mslaby96/spindle/hardware/stand/cover.stl

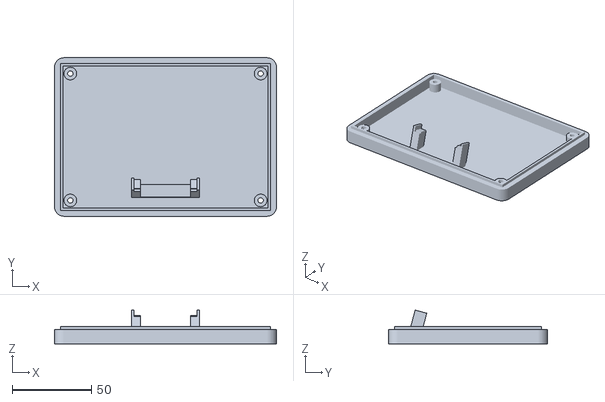
[picture p1: CAD file, 2026-11-01]
hardware/stand/cover.stl
140.0 x 100.0 x 21.3
