mslaby96/spindle/hardware/stand/clip.stl

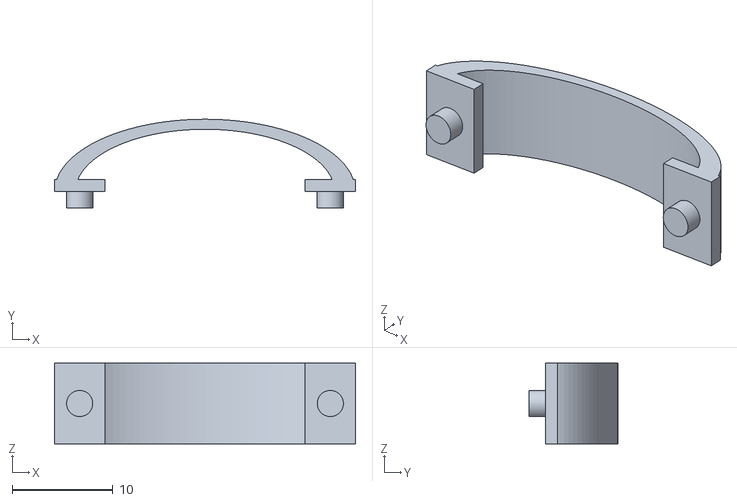
[picture p2: CAD file, 2026-10-30]
hardware/stand/clip.stl
29.9 x 8.80 x 8.00
