mslaby96/spindle/hardware/stand/foot.stl

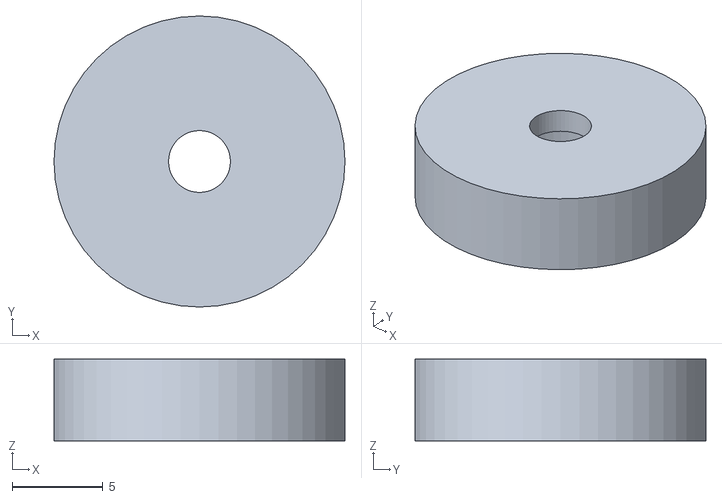
[picture p3: CAD file, 2026-10-30]
hardware/stand/foot.stl
16.0 x 16.0 x 4.50
