mslaby96/spindle/hardware/stand/body.stl

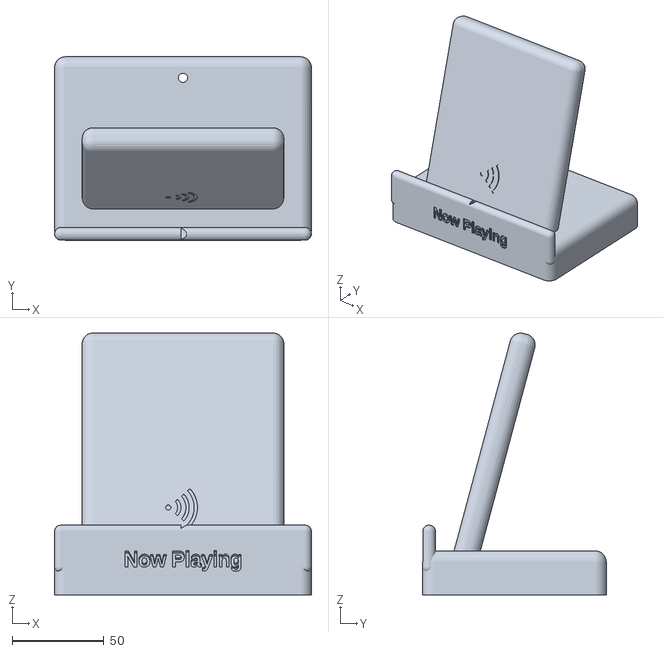
[picture p4: CAD file, 2026-10-29]
hardware/stand/body.stl
140.0 x 100.0 x 142.6
