mslaby96/spindle/(commit log)

2026-10-27 Add account setup, login sessions and device tokens
2026-10-27 Add device report endpoint and live event stream
2026-10-27 Add Pico W firmware for the now playing stand
2026-10-27 Track listening sessions from the stand with confirmation for long ones
2026-10-28 Fix edge cases in sessions, inbox and login limits; tidy up
    [runner.py]
2026-10-28 Keep the driver licence out of the files copied to the Pico
2026-10-28 Fix MFRC522 SPI writes on MicroPython 1.2x and add a reader probe
2026-10-28 Halt the tag after each read instead of cycling the antenna
2026-10-28 Add a printable now playing stand
    [body.stl, cover.stl, stand.scad]
2026-10-28 Give the stand cover feet with recessed screw heads
    [cover.stl, stand.scad]
2026-10-28 Mark the reader on the backrest and smooth the front face
    [body.stl, stand.scad]
2026-10-28 Load the reader from below and close the back of the stand
    [body.stl, spacer.stl, stand.scad]
2026-10-28 Keep the reader's pin header inside the base
    [body.stl, spacer.stl, stand.scad]
2026-10-28 Let the reader board locate its spacer
    [spacer.stl, stand.scad]
2026-10-28 Keep the web app in step with the server after drops and expiry
    - any 401 re-checks the session, so an expired login lands on sign in
    instead of a page full of errors, and the event stream stops retrying
    - after the stream reconnects, now playing, inbox and catalogue state
    are fetched again since missed events are not replayed
    - assigning a sleeve updates now playing straight from the response
    - cataloguing is re-checked when it is due to lapse
    - the startup gate shows an error with a retry instead of loading forever
    - test fetch mock rejects writes without the X-Spindle header
2026-10-28 Make the stand fail visibly and back off when the server is down
    A bad pin or LED setting crashed before the error pattern was shown and
    the watchdog rebooted the board in a loop; config is now checked up front
    and hardware is set up before the watchdog starts. A reader exception no
    longer ends the loop, failed reports back off up to 30 s, the HTTP
    timeout leaves room inside the watchdog window, and a Wi-Fi attempt stuck
    in connecting is retried.
    [net.py, report.py, runner.py]
2026-10-28 Share the devices query, pressing format and debounce hook
    Each was written out in two places.
2026-10-29 Pin what listen events and classification report
    Mutation testing showed the tests never checked that a new listen is
    announced as active, when it started, the exact long-listen boundary,
    that a discarded listen credits no time, or that ClassifyAlbum handles
    every waiting listen.
2026-10-29 Split the most complex server functions
    Every function now scores under 10 on crap4go. HTTP handlers share one
    table that maps domain errors to statuses instead of each repeating
    its own switch; the dominant colour picks a fixed bucket on ties instead
    of depending on map order. Behaviour is otherwise unchanged and covered
    by the existing tests.
2026-10-29 Tell Home Assistant when Spindle shuts down
    The MQTT connection shared the server's context, so it was already
    closing when the offline message went out and the broker kept the
    retained "online". The connection now lives until the offline message
    is sent and the client has disconnected.
2026-10-29 Drop an unreachable empty-colour branch
    Every mean is built from at least one sample.
2026-10-29 Cover what mutation testing showed the tests missed
    Boundaries (session idle deadlines, login backoff, catalogue expiry,
    ratings, limits, track counts), sources tried in order, error paths
    that reach the user, and constants the tests used to compare against
    themselves.
2026-10-29 Test the MQTT last will, status filter and cover scaling
    A third mutation pass on single workers showed the earlier config and
    publisher results were noisy. The broker now drops the publisher's
    socket to check the offline will, only an "online" on Home
    Assistant's status topic triggers a resync, and covers wider or taller
    than 600 px are scaled on that side. Config defaults, the summary and
    the secret and factor boundaries are pinned too.
2026-10-29 Make the reader spacer part of the cover and print the feet separately
    A loose spacer could tip over or fall out while the cover was off. It
    now stands on the cover, which prints flat side down; the feet are
    separate pieces held by the cover screws, centred by a small ring.
    The spacer's lips get 0.3 mm more room since the screws now decide
    where it sits. Checked in OpenSCAD that the cover clears the body, the
    reader board and the Pico.
    [cover.stl, foot.stl, spacer.stl, stand.scad]
2026-10-29 Say that the base ceiling needs support
    The underside of the base spans about 13 x 9 cm, too far to bridge.
2026-10-29 Print the base without overhangs at the bed edge
    The base's bottom edges were rounded like the top, which made a lip
    right above the bed that the slicer supported all round, and the USB
    opening had a flat roof. The bottom edges are now straight and the
    opening has a 45 degree roof. The README lists support settings that
    keep the slot clear and the support easy to remove.
    [body.stl, stand.scad]
2026-10-29 Size the screw holes for M3 x 20 machine screws
    Wider bosses with a 2.5 mm pilot hole, 3.4 mm clearance in the cover
    and feet, and taller feet whose recess takes pan, socket or countersunk
    M3 heads.
    [body.stl, cover.stl, foot.stl, stand.scad]
2026-10-29 Leave nothing but the base ceiling for the slicer to support
    The screw holes in the bosses ended flat, so supports grew up inside
    them, and the tops of the engraved letters on the front were flat
    overhangs that got a support wall up the face. The holes now end in a
    point and the letters run into the face at 45 degrees.
    [body.stl, stand.scad]
2026-10-29 Let a stand pair itself with a short code from the app
    The app asks for a six-character code that lasts ten minutes; a stand
    being set up sends it to /api/device/v1/pair and gets its token back.
    Codes skip look-alike characters, work once, and wrong guesses are
    rate limited per address. The app hears about the new stand over the
    event stream.
2026-10-29 Set a stand up from a phone instead of a config file
    A stand without Wi-Fi settings opens an open network named Spindle-XXXX
    with a captive setup page: pick a network, type its password, the
    server address and the pairing code from the app. The stand joins the
    network, trades the code for its token, saves its settings and
    restarts. Holding BOOTSEL for five seconds forgets the Wi-Fi, and five
    minutes without the usual network opens the setup page while the old
    network keeps being retried. Open networks with an empty password now
    pass the config check.
2026-10-29 Walk through setting a stand up from a phone in the app
    The stands page says up front how adding a stand works, then lists the
    steps: plug it in, join its Spindle network, pick the home Wi-Fi, type
    the server address shown right there and the code. Opened as localhost,
    the page warns that the stand needs the computer's home network address
    instead. A "Something not working?" section covers a missing setup
    network, a dropped phone connection and an unreachable server.
2026-10-29 Remove the duplication dry4go found in the server
    Token hashing lived in both auth and devices and now sits in one
    secrets package. Handlers share reply, act and fetch instead of each
    spelling out the call, error and JSON steps, and every missing album is
    the same known error. The Discogs master and release fetches share one
    generic lookup.
2026-10-29 Turn copy-pasted tests into tables
    The dominant colour, Last.fm tracklist and repeated-play tests repeated
    the same body per case, and the fake Discogs did the same lookup twice.
    Cover removal gets its own test now that it is a store method.
2026-10-30 Pin what mutation testing found unchecked in album removal
    A single listen is enough to ask before moving it, the removal time is
    stored to the second, a cover that can't be deleted is reported, the
    app is told only about album changes that happened, and album lengths
    are checked at both ends.
2026-10-30 Fit the cover flush and hold the reader still, without reprinting the body
    The cover now sits inside the base, flush with its bottom, with the
    bosses through it, and wider feet hold it up. The spacer is sized to
    the measured 39.4 x 59.8 mm board and pushes it against the top of its
    pocket, with a 1 mm lip behind its edge that clears the crystal. A
    printed clip on the antenna-end mounting holes presses the antenna
    against the front of the pocket. The body renders to the same geometry
    as before, and OpenSCAD shows no part running into another.
    [clip.stl, cover.stl, foot.stl, stand.scad]
2026-10-30 Drop a check filingKey can never fail
    The key is trimmed before "the " is cut, so something always follows.
2026-10-30 Take a cover's colour from its most colourful area
    The largest colour area often isn't what a cover looks like: on Damn it
    was the shirt, a pale lavender that appears nowhere else. A colourful
    area covering at least 5% of the cover now wins over a larger pale one;
    covers without one keep the old rule. Tests pin both thresholds on each
    side. Store.Color reads a stored cover back for recolouring.
2026-10-30 Add a command to pick cover colours again
    Albums catalogued before the new colour rule keep their old colour.
    spindle recolor-covers recomputes it from every stored cover, reports
    covers it can't read and carries on with the rest. Home Assistant gets
    the new colour with the next now playing update.
2026-10-30 Give the sort dropdown its own arrow
    The browser's arrow sat squeezed against the right edge and looked out
    of place next to the filter field. The select now draws its own arrow
    in the secondary text colour with room on the right, matches the field
    beside it and highlights its border on hover.
2026-11-01 Put the cover back under the base as a tray with more room
    The flush cover could slide up the bosses with nothing to hold it while
    assembling, and wires on a breadboard didn't fit above it. The cover is
    now a tray with the base's outline that adds 6 mm inside; its rim drops
    into the base to line it up, posts under the bosses take the screws,
    and the reader spacer stands on its floor. The body renders unchanged
    and nothing collides.
    [cover.stl, stand.scad]
2026-11-01 Open stand setup in the browser instead of a captive portal sheet
    On an iPhone the captive portal sheet closes, and leaves the network,
    as soon as you switch to another app, say to copy a Wi-Fi password.
    The stand now answers the phones' connectivity checks as online, so no
    sheet appears, and the setup page is opened at http://spindle.setup in
    the browser, which survives switching apps. Any other name still leads
    to the page.
2026-11-01 Mark a sleeve taken off the stand with a sticker
    While the listen winds down, a "Sleeve off" sticker states what
    happened, the countdown is set in the clock's condensed numerals and
    the "End listen now" button sits below it, all under a rule that
    separates it from the progress bar.
2026-11-01 Let an empty stand idle on less power
    With nothing on it the stand reads every 300 ms with the reader's field
    up only for the read, lets the Wi-Fi doze between beacons, and the
    server asks it to report every 30 s instead of 1.5 s; putting a sleeve
    on is still reported at once and confirmed at full speed. Checked on
    the stand: reads with the field switched per read are as reliable as
    with it on, and a test pins that going back to full speed turns the
    field on again, which the first hardware run caught.
2026-11-01 Back up the database and covers, and restore them
    The server writes a backup every SPINDLE_BACKUP_EVERY (24 h by default)
    into SPINDLE_BACKUP_DIR and keeps the newest SPINDLE_BACKUP_KEEP. It
    starts at once when the last one is already that old, so restarts don't
    push it back. Docker mounts SPINDLE_BACKUP_PATH from the host there.
    The database is copied with VACUUM INTO, so it is consistent while the
    server keeps running. spindle backup makes one by hand. spindle restore
    checks the archive, takes only the database and cover files from it,
    and moves the current data aside instead of deleting it.
2026-11-01 Split the backup archive steps
    writeArchive, extract and Restore were over a CRAP of 10; the covers,
    each archive entry, and unpacking versus moving in are now their own
    functions. The backup tests pin the behaviour.
2026-11-01 Pin what mutation testing found unchecked in backups and export
    Every cover goes into a backup, pruning leaves other archives in the
    folder alone, an oddly named file doesn't make a backup due, a database
    without covers is still moved aside on restore, the scheduler keeps
    going after the first backup, and export times are exact.
2026-11-01 Name backups in local time and say where restore put the old data
    Backup names used the container's UTC clock instead of SPINDLE_TZ.
    Restore now returns the before-restore folder, so the command only
    mentions one when something was actually moved there.
2026-11-01 Show the data downloads as buttons
    The JSON and CSV export links on the account page rendered as plain
    underlined links. Links marked as buttons now look and size like the
    buttons next to them, and a row of them sits side by side from the left.
2026-11-01 Reset the reader when it gets stuck
    Cheap RC522 boards can lose their settings after a dip in power or stop
    answering on SPI, and then read every sleeve as nothing on the stand
    until the Pico is restarted. An empty stand now checks every 30 s that
    the reader still holds what it was set up with, and if not, resets it
    through its RST pin and sets it up again. Checked on the stand: no false
    alarms on a healthy reader, and knocking its settings out gets healed
    on the next check. Firmware is now 0.3.0.
    [health.py, reader.py, runner.py]
2026-11-01 Tell when a stand goes offline and keep its diagnostics
    A stand counts as offline after 90 s without a report and comes back with
    its first one. Reports may carry Wi-Fi signal, reader resets and uptime;
    the app gets them with the stand list and a device_status event when a
    stand goes quiet or comes back.
2026-11-01 Send Wi-Fi signal, reader resets and uptime with each report
    [net.py, report.py, runner.py]
2026-11-01 Show whether each stand is online and how it is doing
    Each stand on the Stands page carries an Online or Offline sticker, says
    since when it has been offline, and lists what it last reported: Wi-Fi
    strength in words with the dBm next to it, reader resets and uptime,
    marked as last known while it is offline. The page refreshes those
    every 30 seconds. When nothing is playing and every stand is offline,
    Now playing says the stand isn't answering and what to check instead of
    asking for a sleeve. Tests pin the signal thresholds at -67 and -80 dBm,
    the uptime wording and both empty states.
2026-11-01 Let a stand's Wi-Fi be changed from the Stands page
    Change Wi-Fi first explains what will happen: the stand forgets its
    network, opens its own Spindle- network and keeps its history, and
    setup continues on the phone at http://spindle.setup. After confirming,
    the stand shows a Wi-Fi change sticker and waits for the stand to pick
    the request up, which can be cancelled until then; an offline stand
    says it will pick it up when it is back. Once it does, the page says
    what to do next on the phone.
2026-11-01 Let the stand install firmware from its server and roll back a bad one
    A new version is downloaded into next/, checked file by file and put in
    place at the next boot, with the old files kept in prev/. Until the new
    version reaches the server, main.py keeps a watchdog running; three
    resets in a row, or ten minutes without the server, bring the old
    version back.
    [main.py, net.py, ota.py, patterns.py, report.py, runner.py]
2026-11-01 Give stands their firmware from the server and track each update
    The Docker image carries the stand's code. A stand on another version can
    be asked to update from the app; it is told so on its next report while
    empty, downloads the files from /api/device/v1/firmware/ and reports
    either the new version or that it failed.
2026-11-01 Let a stand's firmware be updated from the Stands page
    When the server has newer firmware than a stand runs, the stand shows
    it next to its version with an Update button. A requested update says
    it waits for the stand's next report and for no record to be on it, and
    can be cancelled; an installing one says the stand restarts and is back
    in about a minute; a failed one says the stand is back on its old
    version and can be dismissed or tried again. When the stand comes back
    on the new version the row says so.
2026-11-02 License the software under AGPL-3.0 and the hardware under CERN-OHL-S-2.0
    [stand.scad]
2026-11-02 Say when a page can't load instead of showing nothing
    A failed request left pages blank, and Now playing claimed nothing was
    on the stand. Every page now says what it couldn't load and why, with
    a Try again button, and shows Loading only when loading takes more
    than a moment. Failed requests are retried once instead of three times,
    and not at all when the server refused them on purpose, so the error
    shows up in about a second.
2026-11-02 Keep a paired stand's setup network private and its token at home
    A paired stand's setup network now has a password the app shows, and its
    setup page no longer takes another server, so the token only goes where
    it was issued. Pairing codes are never shown again on the page, and
    main.py and ota.py are no longer replaced by updates.
    [ota.py, portal.py]
2026-11-02 Make the app work from the keyboard and with a screen reader
    The rating is one stop for Tab and moves by half a star with the arrow
    keys. The library's two views are real tabs with arrow keys, while the
    stats period and measure are pressed buttons, since they filter rather
    than switch views. A skip link jumps past the navigation, and the inbox
    link reads "Inbox, 2 waiting". A sleeve taken off the stand is
    announced once instead of every second of the countdown. The album
    search only takes focus while cataloguing, so it no longer pops the
    phone keyboard over the inbox or Now playing.
2026-11-02 Polish the diary, the weekly chart and a few loose ends
    The weekly chart always covered half a year whatever period was
    picked; it now spans the same stretch as the lists below it. Diary
    listens show their time, and a day's date appears once instead of on
    every listen of that day. The album length button says Look it up
    instead, since it replaces your own length. A few stray font sizes and
    corner radii now sit on the same steps as the rest.
2026-11-02 Show a stand's Wi-Fi as a signal icon
    Instead of "Wi-Fi strong -58 dBm" each stand shows the familiar Wi-Fi
    fan with one, two or three arcs lit for weak, ok and strong, using the
    same thresholds as before, and no dBm. Screen readers and hover still
    get "Wi-Fi signal: strong (3 of 3)".
2026-11-02 Rate limit by account and real client, and secure cookies over HTTPS
    Behind a proxy listed in SPINDLE_TRUSTED_PROXIES the client is read from
    X-Forwarded-For, and IPv6 clients count per /64. Logins are also limited
    per username, pairing has its own limiter, and a success only takes back
    its own attempt instead of clearing earlier failures. Old failures are
    forgotten after 15 minutes. Session cookies get Secure, and responses
    HSTS, whenever the request came over HTTPS.
2026-11-02 Cap session age, expire the setup code and turn away logins when busy
    Sessions end a month after their last use, or half a year after login,
    and expired ones are purged hourly. The first-run setup code works for an
    hour. A login waits at most five seconds for a password hashing slot and
    then gets 503, so a flood can't queue up. Login and setup need the
    X-Spindle header like other requests, logging in again replaces the
    browser's previous session, and reset-password no longer shows what is
    typed.
2026-11-02 Cap what the server reads from outside
    API responses from Discogs, MusicBrainz and Last.fm are read up to 4 MiB,
    covers may have at most 12 million pixels, a restore unpacks at most
    4 GiB, and a stand's reported versions must look like versions.
2026-11-02 Explain running Spindle behind HTTPS and trusted proxies
2026-11-02 Import a Discogs collection into the library
    Pressings of one album are grouped under it, and a new album takes its
    master's original year and cover like one added by hand. An import only
    adds: pressings already there are skipped, and albums removed from the
    collection in Spindle stay out. It runs in the background after a backup
    and reports how far it got.
2026-11-02 Offer records already in the collection when assigning a sleeve
    After a Discogs import most records exist in Spindle before their
    sleeve has a tag, so assigning one through a Discogs search again was
    a detour. Catalogue and the inbox now list the records without a
    sleeve first, a handful at a time with Show all, filtered by artist or
    title, and assign the picked one by its master or release. The Discogs
    search stays below them.
2026-11-02 Credit Discogs next to their data, as their API terms ask
    The album page, every search result and every pressing now carry
    "Data provided by Discogs", linked to that record's page on
    discogs.com, and the account page ends with the notice that Spindle
    uses Discogs' API without being affiliated with or endorsed by them.
2026-11-10 Build Spindle for Linux as single files
2026-11-10 Install Spindle into its own Proxmox LXC container with one command
    The script creates an unprivileged Debian 12 container, installs Spindle
    as a sandboxed systemd service and prints the address and setup code. It
    can start from a backup, and --update backs up before putting in a new
    version. It is tested against stand-ins for the Proxmox tools in CI and
    was run for real against a systemd container.
2026-11-10 Build with Go 1.26.10 and give retried pages answers shaped like the server's
    Go 1.26.0 has known holes in net/http and crypto/x509 that govulncheck
    flags. The load-error test answered every retried page with an empty
    list, which only some pages expect, so Vitest failed on the errors it
    threw afterwards.
2026-11-10 Ask through menus like the Proxmox community scripts do
    Default settings, advanced settings with the storages and bridges to
    pick from, or updating a container tagged spindle; the Discogs token is
    typed into a password box and a summary is confirmed before anything is
    created.
